District25/CircuitDesign/(list of files, drawings)

Other design files:
ElnC_PeakDetector/ElnC_PeakDetector.PrjPcb
PCB_Project_BO6/PCB_Project_BO6/Batterie.SchDoc
PCB_Project_BO6/PCB_Project_BO6/Eurocircuits4L.PcbDoc
PCB_Project_BO6/PCB_Project_BO6/FAST.SchDoc
PCB_Project_BO6/PCB_Project_BO6/PCB_Project_BO6.PrjPcb
PCB_Project_BO6/PCB_Project_BO6/PcbLib1.PcbLib
PCB_Project_BO6/PCB_Project_BO6/PROC.SchDoc
PCB_Project_BO6/PCB_Project_BO6/SLOW.SchDoc
PCB_Project_BO6/PCB_Project_BO6/STM.SchLib
