District25/CircuitDesign/(commit log)

2025-04-16 Avancement du projet en cours
    [FAST.SchDoc, SLOW.SchDoc]
2025-04-16 Ajout du bon peak detector
    [ElnC_PeakDetector.PcbDoc, ElnC_PeakDetector.PrjPcb, ElnC_PeakDetector.SchDoc]
2025-04-16 Ajout du Peak Detector pour le Slow Sampling, Fast Sampling partiellement fini
    [ElnC_PeakDetector.PcbDoc, ElnC_PeakDetector.SchDoc, ElnC_PeakDetector_BO6.PcbDoc, ElnC_PeakDetector_BO6.PrjPcb, ElnC_PeakDetector_BO6.SchDoc, SLOW.SchDoc]
2025-05-07 Ajout des fichiers Mathlab qui servent au dimensionnement des résistances des batteries
2025-06-16 Final commit
    [Batterie.SchDoc, Eurocircuits4L.PcbDoc, FAST.SchDoc, PCB_Project_BO6.PrjPcb, PROC.SchDoc, PcbLib1.PcbLib, SLOW.SchDoc, STM.SchLib]
2025-06-16 Supp prj altium peak detector
    [ElnC_PeakDetector_BO6.PcbDoc, ElnC_PeakDetector_BO6.PrjPcb, ElnC_PeakDetector_BO6.SchDoc]
